GlowElectronics/Novus-T1200XE/Eagle/README.md

## Eagle Files

Coming soon!

The Eagle schematic and board files will be released when the "Pro" version of the board is complete.
