GlowElectronics/Novus-T1200XE/Arduino/usbasp-pinout.jpg

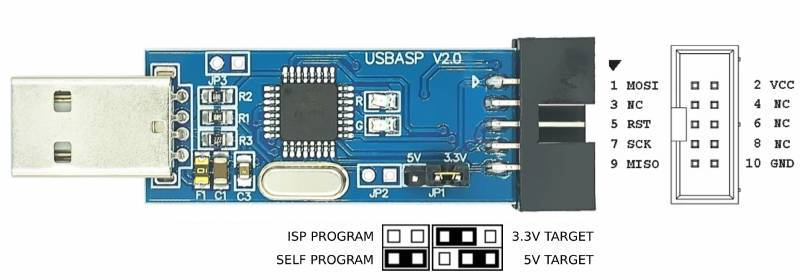
Arduino/usbasp-pinout.jpg
