GlowElectronics/Novus-T1200XE/Hardware/Lite/novus_t1200xe_pm_dual_0.8.1_pa_voltages.png

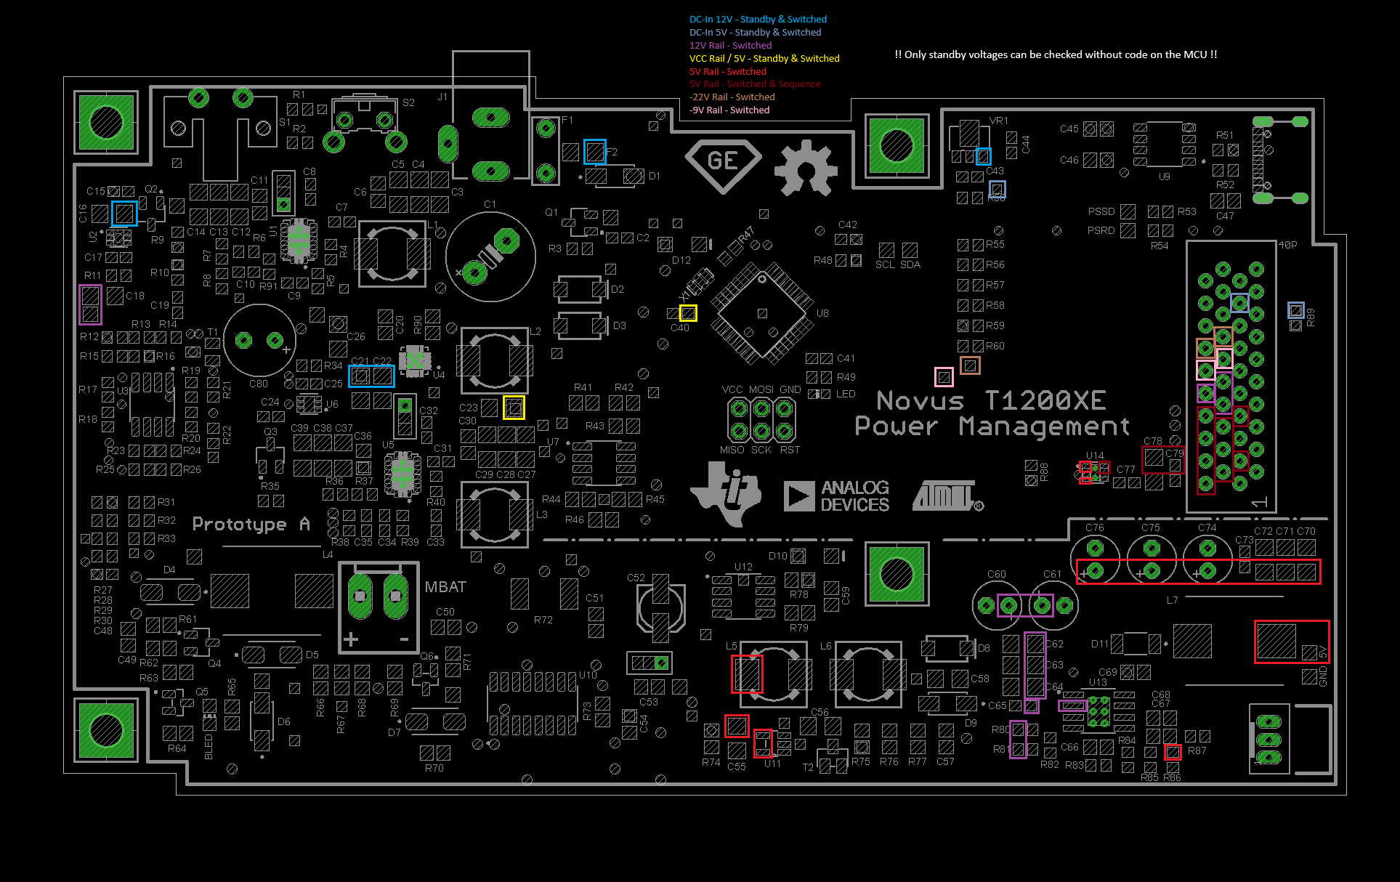
Hardware/Lite/novus_t1200xe_pm_dual_0.8.1_pa_voltages.png
