GlowElectronics/Novus-T1200XE/Hardware/Lite/novus_t1200xe_0.8.1_pa_basic_bom_th.xlsx

Designator | Value | Footprint | JLCPCB | Information
C1 | 1000uF 25V | P5 D10,5mm | C88727 | -25℃~+105℃ 1000uF 10mm 16mm 2000hrs@105℃ 25V 5mm 740mA@120Hz ±20% Plugin,D10xL16mm Aluminum Electrolytic Capacitors - Leaded ROHS
C60 | 100uF 25V | P2,5 D6mm | C698156 | -55℃~+105℃ 100uF 2.5mm 25V 5000hrs@105℃ 6.3mm 8mm ±20% Plugin,D6.3xL8mm Polymer Aluminum Capacitors ROHS
C61 | 100uF 25V | P2,5 D6mm | C698156 | -55℃~+105℃ 100uF 2.5mm 25V 5000hrs@105℃ 6.3mm 8mm ±20% Plugin,D6.3xL8mm Polymer Aluminum Capacitors ROHS
C74 | 220uF 10V | P2,5 D6mm | C556207 | -55℃~+105℃ 10V 2.5mm 2000hrs@105℃ 220uF 6.3mm 8mm ±20% Plugin,D6.3xL8mm Polymer Aluminum Capacitors ROHS
C75 | 220uF 10V | P2,5 D6mm | C556207 | -55℃~+105℃ 10V 2.5mm 2000hrs@105℃ 220uF 6.3mm 8mm ±20% Plugin,D6.3xL8mm Polymer Aluminum Capacitors ROHS
C76 | 220uF 10V | P2,5 D6mm | C556207 | -55℃~+105℃ 10V 2.5mm 2000hrs@105℃ 220uF 6.3mm 8mm ±20% Plugin,D6.3xL8mm Polymer Aluminum Capacitors ROHS
J1 | DC-005-5A-3.0 | DC_Jack | C388625 | -20℃~+70℃ 24V 3mm 5A 6.2mm DC Power Jack Right Angle Plugin DC Power Connectors ROHS
S2 | Switch 6.2x6.2mm | SKHHLUA010 | C139764 | -40℃~+90℃ 1,000,000 cycles 12V 1N 5.85mm 50mA 6.2mm 6.2mm PC Pin Right Angle Round Button SPST-NO 弯插,6.2x6.2mm Tactile Switches ROHS
