GlowElectronics/Novus-T1200XE/Hardware/Lite/novus_t1200xe_0.8.1_pa_basic_bom_all.xlsx

Designator | Value | Footprint | JLCPCB | Information
C15 | 100nF 25V | C0603 | C327087 | 100nF 25V X7R ±5% 0603 Multilayer Ceramic Capacitors MLCC - SMD/SMT ROHS
C16 | 10uF 25V | C1206 | C6119987 | 10uF 25V X7R ±10% 1206 Multilayer Ceramic Capacitors MLCC - SMD/SMT ROHS
C17 | 4.7nF 25V | C0603 | C519524 | 25V 4.7nF X7R ±5% 0603 Multilayer Ceramic Capacitors MLCC - SMD/SMT ROHS
C18 | 10uF 25V | C1206 | C6119987 | 10uF 25V X7R ±10% 1206 Multilayer Ceramic Capacitors MLCC - SMD/SMT ROHS
C19 | 100nF 25V | C0603 | C327087 | 100nF 25V X7R ±5% 0603 Multilayer Ceramic Capacitors MLCC - SMD/SMT ROHS
C2 | 100nF 25V | C0603 | C327087 | 100nF 25V X7R ±5% 0603 Multilayer Ceramic Capacitors MLCC - SMD/SMT ROHS
C20 | 3.3nF 16V | C0805 | C519913 | 16V 3.3nF X7R ±10% 0805 Multilayer Ceramic Capacitors MLCC - SMD/SMT ROHS
C21 | 10uF 25V | C1206 | C6119987 | 10uF 25V X7R ±10% 1206 Multilayer Ceramic Capacitors MLCC - SMD/SMT ROHS
C22 | 10uF 25V | C1206 | C6119987 | 10uF 25V X7R ±10% 1206 Multilayer Ceramic Capacitors MLCC - SMD/SMT ROHS
C23 | 22uF 10V | C1206 | C6119994 | 10V 22uF X7R ±10% 1206 Multilayer Ceramic Capacitors MLCC - SMD/SMT ROHS
C40 | 100nF 16V | C0603 | C109474 | 100nF 16V X7R ±5% 0603 Multilayer Ceramic Capacitors MLCC - SMD/SMT ROHS
C41 | 100nF 16V | C0603 | C109474 | 100nF 16V X7R ±5% 0603 Multilayer Ceramic Capacitors MLCC - SMD/SMT ROHS
C42 | 100nF 16V | C0603 | C109474 | 100nF 16V X7R ±5% 0603 Multilayer Ceramic Capacitors MLCC - SMD/SMT ROHS
C43 | 1uF 10V | C0603 | C519559 | 10V 1uF X7R ±5% 0603 Multilayer Ceramic Capacitors MLCC - SMD/SMT ROHS
C44 | 1uF 25V | C0603 | C106858 | 1uF 25V X7R ±10% 0603 Multilayer Ceramic Capacitors MLCC - SMD/SMT ROHS
C45 | 100nF 16V | C0805 | C520082 | 100nF 16V X7R ±5% 0805 Multilayer Ceramic Capacitors MLCC - SMD/SMT ROHS
C46 | 100nF 16V | C0805 | C520082 | 100nF 16V X7R ±5% 0805 Multilayer Ceramic Capacitors MLCC - SMD/SMT ROHS
C47 | 100nF 16V | C0805 | C520082 | 100nF 16V X7R ±5% 0805 Multilayer Ceramic Capacitors MLCC - SMD/SMT ROHS
C55 | 1uF 25V | C1206 | C107184 | 1uF 25V X7R ±10% 1206 Multilayer Ceramic Capacitors MLCC - SMD/SMT ROHS
C56 | 1uF 25V | C1206 | C107184 | 1uF 25V X7R ±10% 1206 Multilayer Ceramic Capacitors MLCC - SMD/SMT ROHS
C57 | 220pF 50V | C0805 | C61747 | 220pF 50V C0G ±5% 0805 Multilayer Ceramic Capacitors MLCC - SMD/SMT ROHS
C58 | 22uF 25V | C1206 | C12891 | 22uF 25V X5R ±10% 1206 Multilayer Ceramic Capacitors MLCC - SMD/SMT ROHS
C59 | 1uF 16V | C0805 | C520051 | 16V 1uF X7R ±5% 0805 Multilayer Ceramic Capacitors MLCC - SMD/SMT ROHS
C62 | 10uF 25V | C1206 | C6119987 | 10uF 25V X7R ±10% 1206 Multilayer Ceramic Capacitors MLCC - SMD/SMT ROHS
C63 | 10uF 25V | C1206 | C6119987 | 10uF 25V X7R ±10% 1206 Multilayer Ceramic Capacitors MLCC - SMD/SMT ROHS
C64 | 10uF 25V | C1206 | C6119987 | 10uF 25V X7R ±10% 1206 Multilayer Ceramic Capacitors MLCC - SMD/SMT ROHS
C65 | 100nF 25V | C0603 | C327087 | 100nF 25V X7R ±5% 0603 Multilayer Ceramic Capacitors MLCC - SMD/SMT ROHS
C66 | 10nF 25V | C0805 | C519911 | 10nF 25V X7R ±10% 0805 Multilayer Ceramic Capacitors MLCC - SMD/SMT ROHS
C67 | 2.2nF 16V | C0805 | C519912 | 16V 2.2nF X7R ±10% 0805 Multilayer Ceramic Capacitors MLCC - SMD/SMT ROHS
C68 | 22pF 50V | C0805 | C105623 | 22pF 50V NP0 ±5% 0805 Multilayer Ceramic Capacitors MLCC - SMD/SMT ROHS
C69 | 100nF 16V | C0805 | C520082 | 100nF 16V X7R ±5% 0805 Multilayer Ceramic Capacitors MLCC - SMD/SMT ROHS
C70 | 22uF 10V | C1206 | C6119994 | 10V 22uF X7R ±10% 1206 Multilayer Ceramic Capacitors MLCC - SMD/SMT ROHS
C71 | 22uF 10V | C1206 | C6119994 | 10V 22uF X7R ±10% 1206 Multilayer Ceramic Capacitors MLCC - SMD/SMT ROHS
C72 | 22uF 10V | C1206 | C6119994 | 10V 22uF X7R ±10% 1206 Multilayer Ceramic Capacitors MLCC - SMD/SMT ROHS
C73 | 100nF 10V | C0603 | C519438 | 100nF 10V X7R ±10% 0603 Multilayer Ceramic Capacitors MLCC - SMD/SMT ROHS
C77 | 10nF 6V3 | C0603 | C519509 | 10nF 16V X7R ±5% 0603 Multilayer Ceramic Capacitors MLCC - SMD/SMT ROHS
C78 | 22uF 10V | C1206 | C6119994 | 10V 22uF X7R ±10% 1206 Multilayer Ceramic Capacitors MLCC - SMD/SMT ROHS
C79 | 1uF 10V | C0603 | C519559 | 10V 1uF X7R ±5% 0603 Multilayer Ceramic Capacitors MLCC - SMD/SMT ROHS
D1 | SMAJ15A | DIOM4325X250N | C110520 | -55℃~+150℃ 15V 16.4A 18.5V 24.4V 400W@8.3ms 5uA TVS Unidirectional SMA ESD and Surge Protection (TVS/ESD) ROHS
D10 | 1N5817 | SOD-123 | C169541 | 1A 1mA@20V 20V 25A 450mV@1A SOD-123FL Schottky Diodes ROHS
D11 | SS54FSH | SODFL4725X110N | C22452 | -55℃~+125℃ 1mA@40V 40V 550mV@5A 5A Independent SMA(DO-214AC) Schottky Diodes ROHS
D12 | 1N5817 | SOD-123 | C169541 | 1A 1mA@20V 20V 25A 450mV@1A SOD-123FL Schottky Diodes ROHS
D2 | SS14 Schottky Diode | SMA | C83852 | 1A 200uA@40V 40A 40V 500mV@1A SMA(DO-214AC) Schottky Diodes ROHS
D3 | SS14 Schottky Diode | SMA | C83852 | 1A 200uA@40V 40A 40V 500mV@1A SMA(DO-214AC) Schottky Diodes ROHS
D8 | SS14 Schottky Diode | SMA | C83852 | 1A 200uA@40V 40A 40V 500mV@1A SMA(DO-214AC) Schottky Diodes ROHS
D9 | RS1A | SMA | C437731 | -55℃~+150℃@(Tj) 1.3V@1A 150ns 1A 30A 50V 5uA@50V Independent SMA Fast Recovery / High Efficiency Diodes ROHS
F2 | 16V/4A | F1206 | C70173 | 1.5W 16mΩ 16s 1mΩ 4A 50A 6V 8A 1206 Resettable Fuses ROHS
J2 | USB-TYPE-C-020 | USB-C-16P | C165948 | -30℃~+80℃ 1 10,000 cycles 16P 20V 5A 7.35mm Female Surface Mount, Right Angle Type-C SMD USB Connectors ROHS
L2 | SMMS0630-2R2 | DR74 | C128686 | 11.5A 2.2uH 20mΩ Molded Inductor ±20% SMD,7.3x6.6mm Power Inductors ROHS
L5 | SMMS0630-100M | 0630 10UH | C128692 | 10uH 5.5A 68mΩ Molded Inductor ±20% SMD,7.3x6.6mm Power Inductors ROHS
L6 | SMMS0630-100M | 0630 10UH | C128692 | 10uH 5.5A 68mΩ Molded Inductor ±20% SMD,7.3x6.6mm Power Inductors ROHS
L7 | MWSA1004S-4R7MT | SMD,11x10mm | C408484 | 13A 20mΩ 4.7uH 9A ±20% SMD,11x10mm Power Inductors ROHS
LED | KT-0805G | LED0805 | C2297 | -40℃~+85℃ 100mW 120° 2.6V~3.1V 430mcd 513nm~528nm 525nm 5mA Emerald Green 0805 LED Indication - Discrete ROHS
Q1 | AO3407A | SOT-23 | C15155 | 1 P-Channel 16nC@10V 2.5V@250uA 30V 4.3A 48mΩ@10V 830pF 92pF@15V SOT-23 MOSFETs ROHS
Q2 | AO3407A | SOT-23 | C15155 | 1 P-Channel 16nC@10V 2.5V@250uA 30V 4.3A 48mΩ@10V 830pF 92pF@15V SOT-23 MOSFETs ROHS
R1 | 100K | R0603 | C14675 | -55℃~+155℃ 100kΩ 100mW 75V Thick Film Resistor ±1% ±100ppm/℃ 0603 Chip Resistor - Surface Mount ROHS
R2 | 10K | R0603 | C98220 | -55℃~+155℃ 100mW 10kΩ 75V Thick Film Resistor ±1% ±100ppm/℃ 0603 Chip Resistor - Surface Mount ROHS
R26 | 10K | R0603 | C98220 | -55℃~+155℃ 100mW 10kΩ 75V Thick Film Resistor ±1% ±100ppm/℃ 0603 Chip Resistor - Surface Mount ROHS
R3 | 100K | R0603 | C14675 | -55℃~+155℃ 100kΩ 100mW 75V Thick Film Resistor ±1% ±100ppm/℃ 0603 Chip Resistor - Surface Mount ROHS
R47 | 10K | R0603 | C98220 | -55℃~+155℃ 100mW 10kΩ 75V Thick Film Resistor ±1% ±100ppm/℃ 0603 Chip Resistor - Surface Mount ROHS
R48 | 10K | R0603 | C98220 | -55℃~+155℃ 100mW 10kΩ 75V Thick Film Resistor ±1% ±100ppm/℃ 0603 Chip Resistor - Surface Mount ROHS
R49 | 330R | R0603 | C105881 | -55℃~+155℃ 100mW 330Ω 75V Thick Film Resistor ±1% ±100ppm/℃ 0603 Chip Resistor - Surface Mount ROHS
R50 | 22R | R0603 | C107701 | -55℃~+155℃ 100mW 22Ω 75V Thick Film Resistor ±1% ±100ppm/℃ 0603 Chip Resistor - Surface Mount ROHS
R51 | 15R | R0603 | C128059 | -55℃~+155℃ 100mW 15Ω 75V Thick Film Resistor ±1% ±100ppm/℃ 0603 Chip Resistor - Surface Mount ROHS
R52 | 15R | R0603 | C128059 | -55℃~+155℃ 100mW 15Ω 75V Thick Film Resistor ±1% ±100ppm/℃ 0603 Chip Resistor - Surface Mount ROHS
R53 | 22R | R0603 | C107701 | -55℃~+155℃ 100mW 22Ω 75V Thick Film Resistor ±1% ±100ppm/℃ 0603 Chip Resistor - Surface Mount ROHS
R54 | 22R | R0603 | C107701 | -55℃~+155℃ 100mW 22Ω 75V Thick Film Resistor ±1% ±100ppm/℃ 0603 Chip Resistor - Surface Mount ROHS
R55 | 22R | R0603 | C107701 | -55℃~+155℃ 100mW 22Ω 75V Thick Film Resistor ±1% ±100ppm/℃ 0603 Chip Resistor - Surface Mount ROHS
R56 | 22R | R0603 | C107701 | -55℃~+155℃ 100mW 22Ω 75V Thick Film Resistor ±1% ±100ppm/℃ 0603 Chip Resistor - Surface Mount ROHS
R57 | 22R | R0603 | C107701 | -55℃~+155℃ 100mW 22Ω 75V Thick Film Resistor ±1% ±100ppm/℃ 0603 Chip Resistor - Surface Mount ROHS
R58 | 22R | R0603 | C107701 | -55℃~+155℃ 100mW 22Ω 75V Thick Film Resistor ±1% ±100ppm/℃ 0603 Chip Resistor - Surface Mount ROHS
R59 | 22R | R0603 | C107701 | -55℃~+155℃ 100mW 22Ω 75V Thick Film Resistor ±1% ±100ppm/℃ 0603 Chip Resistor - Surface Mount ROHS
R60 | 22R | R0603 | C107701 | -55℃~+155℃ 100mW 22Ω 75V Thick Film Resistor ±1% ±100ppm/℃ 0603 Chip Resistor - Surface Mount ROHS
R74 | 1K | R0805 | C95781 | -55℃~+155℃ 125mW 150V 1kΩ Thick Film Resistor ±1% ±100ppm/℃ 0805 Chip Resistor - Surface Mount ROHS
R75 | 10K | R0805 | C84376 | -55℃~+155℃ 10kΩ 125mW 150V Thick Film Resistor ±1% ±100ppm/℃ 0805 Chip Resistor - Surface Mount ROHS
R76 | 330K | R0805 | C114528 | -55℃~+155℃ 125mW 150V 330kΩ Thick Film Resistor ±1% ±100ppm/℃ 0805 Chip Resistor - Surface Mount ROHS
R77 | 330K | R0805 | C114528 | -55℃~+155℃ 125mW 150V 330kΩ Thick Film Resistor ±1% ±100ppm/℃ 0805 Chip Resistor - Surface Mount ROHS
R78 | 240R | R0805 | C228652 | -55℃~+155℃ 125mW 150V 240Ω Thick Film Resistor ±1% ±100ppm/℃ 0805 Chip Resistor - Surface Mount ROHS
R79 | 1K5 | R0805 | C114555 | -55℃~+155℃ 1.5kΩ 125mW 150V Thick Film Resistor ±1% ±100ppm/℃ 0805 Chip Resistor - Surface Mount ROHS
R80 | 680K | R0603 | C137690 | -55℃~+155℃ 100mW 680kΩ 75V Thick Film Resistor ±1% ±100ppm/℃ 0603 Chip Resistor - Surface Mount ROHS
R81 | 30K | R0603 | C100001 | -55℃~+155℃ 100mW 30kΩ 75V Thick Film Resistor ±1% ±100ppm/℃ 0603 Chip Resistor - Surface Mount ROHS
R82 | 130K | R0603 | C163432 | -55℃~+155℃ 100mW 130kΩ 75V Thick Film Resistor ±1% ±100ppm/℃ 0603 Chip Resistor - Surface Mount ROHS
R84 | 1K96 | R0603 | C185352 | -55℃~+155℃ 1.96kΩ 100mW 75V Thick Film Resistor ±1% ±100ppm/℃ 0603 Chip Resistor - Surface Mount ROHS
R85 | 10K2 | R0603 | C183219 | -55℃~+155℃ 10.2kΩ 100mW 75V Thick Film Resistor ±1% ±100ppm/℃ 0603 Chip Resistor - Surface Mount ROHS
R86 | 51R1 | R0603 | C137702 | -55℃~+155℃ 100mW 51.1Ω 75V Thick Film Resistor ±1% ±100ppm/℃ 0603 Chip Resistor - Surface Mount ROHS
R87 | 37K4 | R0603 | C163425 | -55℃~+155℃ 100mW 37.4kΩ 75V Thick Film Resistor ±1% ±100ppm/℃ 0603 Chip Resistor - Surface Mount ROHS
R88 | 22R | R0603 | C107701 | -55℃~+155℃ 100mW 22Ω 75V Thick Film Resistor ±1% ±100ppm/℃ 0603 Chip Resistor - Surface Mount ROHS
R89 | 100K | R0603 | C14675 | -55℃~+155℃ 100kΩ 100mW 75V Thick Film Resistor ±1% ±100ppm/℃ 0603 Chip Resistor - Surface Mount ROHS
R9 | 100K | R0603 | C14675 | -55℃~+155℃ 100kΩ 100mW 75V Thick Film Resistor ±1% ±100ppm/℃ 0603 Chip Resistor - Surface Mount ROHS
R90 | 100K | R0805 | C96346 | -55℃~+155℃ 100kΩ 125mW 150V Thick Film Resistor ±1% ±100ppm/℃ 0805 Chip Resistor - Surface Mount ROHS
T2 | IRLML2803 | SOT-23 | C2590 | -55℃~+150℃@(Tj) 1.2A 1V 250mΩ@10V,910mA 30V 540mW 85pF@25V One N-channel SOT-23 MOSFETs ROHS
U11 | LT1931ES5#TRPBF | TSOT-23-5 | C459870 | -34V~-1.255V 0℃~+70℃@(TA) 1 1.2MHz 1A 2.45V~16V 6mA Built-In Inverting No TSOT-23-5 DC-DC Converters ROHS
U12 | LM337LMX/NOPB | SOIC-8 | C544819 | -25℃~+125℃ 1 1.2V~37V 100mA 40V 60dB@(120Hz) Adjustable Negative Over Current Protection SOIC-8 Voltage Regulators - Linear, Low Drop Out (LDO) Regulators ROHS
U13 | TPS54531DDAR | CONV_TPS54531DDAR | C50605 | -40℃~+85℃@(TA) 1 3.5V~28V 570kHz 5A 800mV~26.04V Adjustable Buck Buck Built-in No SOIC-8-EP DC-DC Converters ROHS
U14 | TPS22965DSGR | SON50P200X200X80-9N | C122837 | -40℃~+85℃ 1 16mΩ 6A 800mV~5.7V Active High Load Switch UDFN-8-EP(2x2) Power Distribution Switches ROHS
U2 | TPS22810DRVR | SON65P200X200X80-7N | C527679 | -40℃~+105℃ 1 2.7V~18V 3A 79mΩ Active High Load Switch Undervoltage Protection(UVP)、Over Temperature Protection WSON-6-EP(2x2) Power Distribution Switches ROHS
U4 | TPS62143RGTR | QFN50P300X300X100-17N | C2070702 | -40℃~+85℃@(TA) 1 17uA 2.5MHz 2A 3V~17V 5V Buck Buck Built-in Fixed Yes TQFN-16-EP(3x3) DC-DC Converters ROHS
U8 | ATMEGA328P | TQFP32-08 | C14877 | -40℃~+85℃ 1.8V~5.5V 10bit 1KB 20MHz 23 2KB 32KB 8 Bit AVR Built-in FLASH TQFP-32(7x7) Microcontrollers (MCU/MPU/SOC) ROHS
U9 | CH340N | SOP-8 | C2977777 | -20℃~+70℃ 1 2Mbps 3.3V USB 2.0 USB to serial SOP-8 USB Converters ROHS
VR1 | CJ78L05 | SOT-89-3L | C2079 | -40℃~+125℃@(Tj) 1 1.7V 100mA 26mA 30V 42uV 49dB@(120Hz) 5V Fixed Positive SOT-89-3L Voltage Regulators - Linear, Low Drop Out (LDO) Regulators ROHS
X1 | Resonator 16Mhz | RESONATOR_MURATA2 | C32180 | -20℃~+80℃ 15pF 16MHz 40Ω SMD3213-3P Ceramic Resonators ROHS
C1 | 1000uF 25V | E5-10,5 | C88727 | -25℃~+105℃ 1000uF 10mm 16mm 2000hrs@105℃ 25V 5mm 740mA@120Hz ±20% Plugin,D10xL16mm Aluminum Electrolytic Capacitors - Leaded ROHS
C60 | 100uF 25V | E2,5-6 | C698156 | -55℃~+105℃ 100uF 2.5mm 25V 5000hrs@105℃ 6.3mm 8mm ±20% Plugin,D6.3xL8mm Polymer Aluminum Capacitors ROHS
C61 | 100uF 25V | E2,5-6 | C698156 | -55℃~+105℃ 100uF 2.5mm 25V 5000hrs@105℃ 6.3mm 8mm ±20% Plugin,D6.3xL8mm Polymer Aluminum Capacitors ROHS
C74 | 220uF 10V | E2,5-6 | C556207 | -55℃~+105℃ 10V 2.5mm 2000hrs@105℃ 220uF 6.3mm 8mm ±20% Plugin,D6.3xL8mm Polymer Aluminum Capacitors ROHS
C75 | 220uF 10V | E2,5-6 | C556207 | -55℃~+105℃ 10V 2.5mm 2000hrs@105℃ 220uF 6.3mm 8mm ±20% Plugin,D6.3xL8mm Polymer Aluminum Capacitors ROHS
C76 | 220uF 10V | E2,5-6 | C556207 | -55℃~+105℃ 10V 2.5mm 2000hrs@105℃ 220uF 6.3mm 8mm ±20% Plugin,D6.3xL8mm Polymer Aluminum Capacitors ROHS
J1 | DC-005-5A-3.0 | DC_Jack | C388625 | -20℃~+70℃ 24V 3mm 5A 6.2mm DC Power Jack Right Angle Plugin DC Power Connectors ROHS
S2 | Switch 6.2x6.2mm | SKHHLUA010 | C139764 | -40℃~+90℃ 1,000,000 cycles 12V 1N 5.85mm 50mA 6.2mm 6.2mm PC Pin Right Angle Round Button SPST-NO 弯插,6.2x6.2mm Tactile Switches ROHS
