GlowElectronics/Novus-T1200XE/Hardware/novus_t1200xe_pm_dual_0.8.1_pa_parts_template.pdf

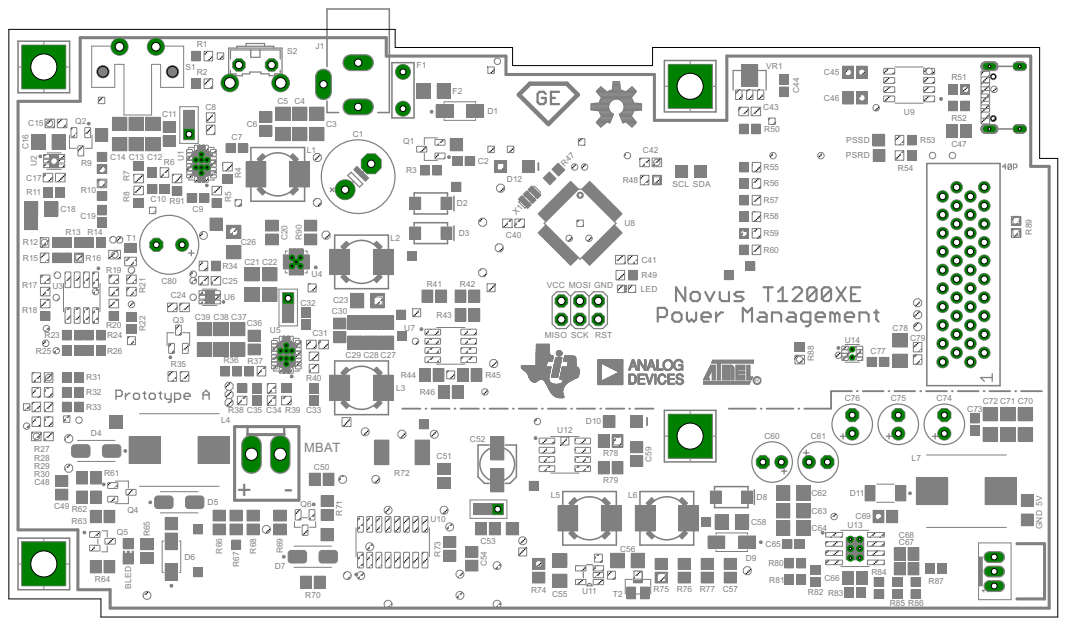
[picture p4: page 1]

VCC MOSI GND MISO SCK RST
