GlowElectronics/Novus-T1200XE/(commit log)

2026-03-01 Files update
    [novus_t1200xe_0.8_pa_basic_bom_smd.xlsx, novus_t1200xe_0.8_pa_basic_bom_th.xlsx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]
2026-03-02 Delete novus_t1200xe_0.8_pa_basic_cpl_smd.xlsx
    Orientation Issue
    [novus_t1200xe_0.8_pa_basic_cpl_smd.xlsx]
2026-03-02 CPL Update
    [novus_t1200xe_0.8_pa_basic_cpl_smd_upd.xlsx]
2026-03-06 Update BoM & CPL
    [novus_t1200xe_0.8.1_pa_basic_bom_all.xlsx, novus_t1200xe_0.8_pa_basic_bom_th.xlsx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]
2026-03-11 DC Jack Part #
    [novus_t1200xe_0.8.1_pa_basic_bom_all.xlsx]
2026-04-06 Voltage List Added
    [novus_t1200xe_0.8.1_pa_basic_bom_th.xlsx]
2026-04-14 Basic > Lite. Setfuses Info.
    [novus_t1200xe_0.8.1_pa_basic_bom_all.xlsx, novus_t1200xe_0.8.1_pa_basic_bom_th.xlsx, novus_t1200xe_0.8_pa_basic_bom_smd.xlsx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]
2026-04-14 Arduino Update
